T-KiriyaShowaDenshi/Kicad/kicad_arduino_LCD/部品表.xlsx

 | リファレンス | 数量 | 部品種類 | メーカー | 型式/定数 | 実装種類 | パッケージ | ピン数/部品 | 合計ピン数 | 備考
1 | C1 C2 C3 C4 | 4 | 1608積層セラミックコンデンサ0.1u |  | C0603C104Z3VACTU | SMD | 1608M | 2 | 8 |  | 合計実装数 | 34 | 合計ピン数 | 109
2 | D1 | 1 | LED Φ5 赤色 |  | HLMP-4700 | DIP |  | 2 | 2 |  | SMD部品数 | 21 | SMDピン数 | 42
3 | LCD1 | 1 | 小型LCD | Xiamen Zettler Electronics Co., Ltd. | AQM0802A-RN-GBW | DIP |  | 9 | 9 |  | DIP部品数 | 13 | DIPピン数 | 67
4 | P1 | 1 | ピンヘッダ（Power） |  | C-00167 | DIP |  | 8 | 8 | 必要ピン数を切り取って実装
5 | P2 | 1 | ピンヘッダ（Analog） |  | C-00167 | DIP |  | 6 | 6 | 必要ピン数を切り取って実装
6 | P3 | 1 | ピンヘッダ（Digital） |  | C-00167 | DIP |  | 10 | 10 | 必要ピン数を切り取って実装
7 | P4 | 1 | ピンヘッダ（Digital） |  | C-00167 | DIP |  | 6 | 6 | 必要ピン数を切り取って実装
8 | R1 R2 | 2 | 1608 一般抵抗 2kΩ |  | RC0603JR-072KL | SMD | 1608M | 2 | 4
9 | R3 R4 R5 R11 R12 R13 R14 R15 R16 R17 | 10 | 1608 一般抵抗 10kΩ |  | RC0603JR-0710KL | SMD | 1608M | 2 | 20
10 | R6 | 1 | 1608 一般抵抗 1kΩ |  | RC06003J 1K | SMD | 1608M | 2 | 2
11 | R7 R8 R9 R10 | 4 | 1608 一般抵抗 4.7kΩ |  | RC0603JR-074K7L | SMD | 1608M | 2 | 8
12 | SW1 SW2 SW3 SW4 | 4 | タクトスイッチ（赤色） |  | SKHHBY | DIP |  | 2 | 8
13 | U1 | 1 | RTCモジュール | アナログデバイセズ | DS1307+ | DIP | SOIC8 | 8 | 8 | 社内在庫なし
14 | U2 | 1 | I2Cバス用双方向電圧レベル変換モジュール | 秋月電子通商 | AE-FXMA2102 | DIP | SOIC8 | 8 | 8 | AE-PCA9306から変更、OEピンをhighにすること
15 | Y1 | 1 | 水晶発振子 |  | NC38 32.768kHz | DIP |  | 2 | 2 | VT-200-F 32.768kHzから変更、社内在庫品
