T-KiriyaShowaDenshi/Kicad/kicad_arduino_LCD/回路図.pdf

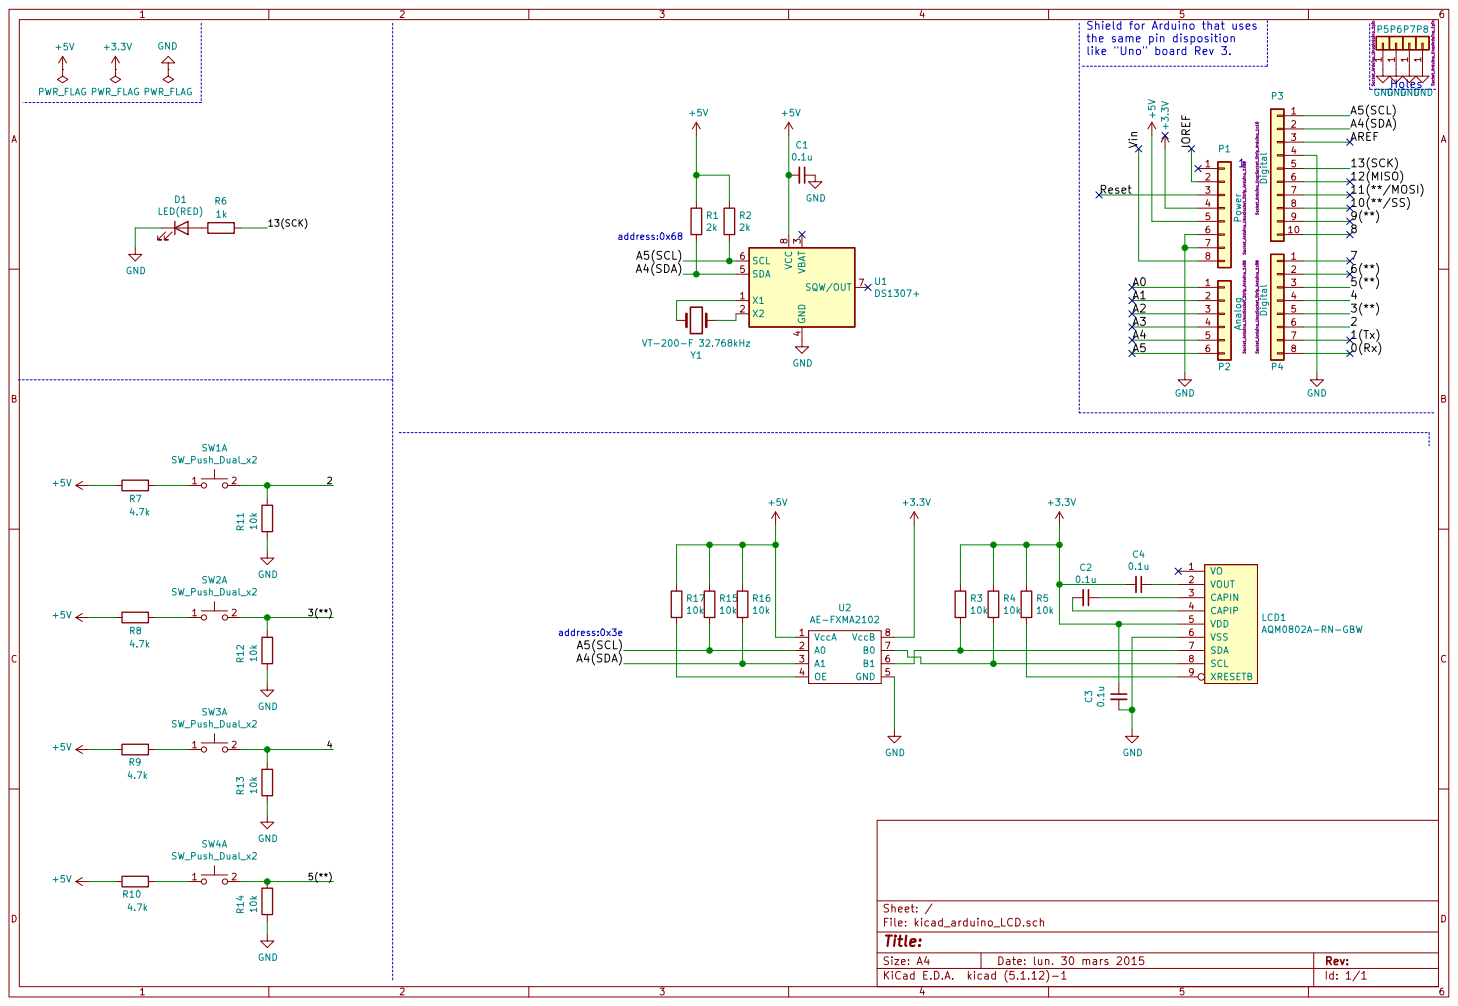
[picture p1: page 1]

the same pin disposition
like "Uno" board Rev 3.

4 SDA 5 SCL 6 SQW/OUT 7 VCC

10k GND GND GND GND R14 10k R13 10k R12 10k R11 10k R7
