T-KiriyaShowaDenshi/Kicad/(list of files, drawings)

Other design files:
kicad_arduino_LCD/kicad_arduino_LCD.dsn
