T-KiriyaShowaDenshi/Kicad/kicad_arduino_LCD/kicad_arduino_LCD.kicad_pcb

## KiCad design kicad_arduino_LCD/kicad_arduino_LCD.kicad_pcb (2021-12-10)

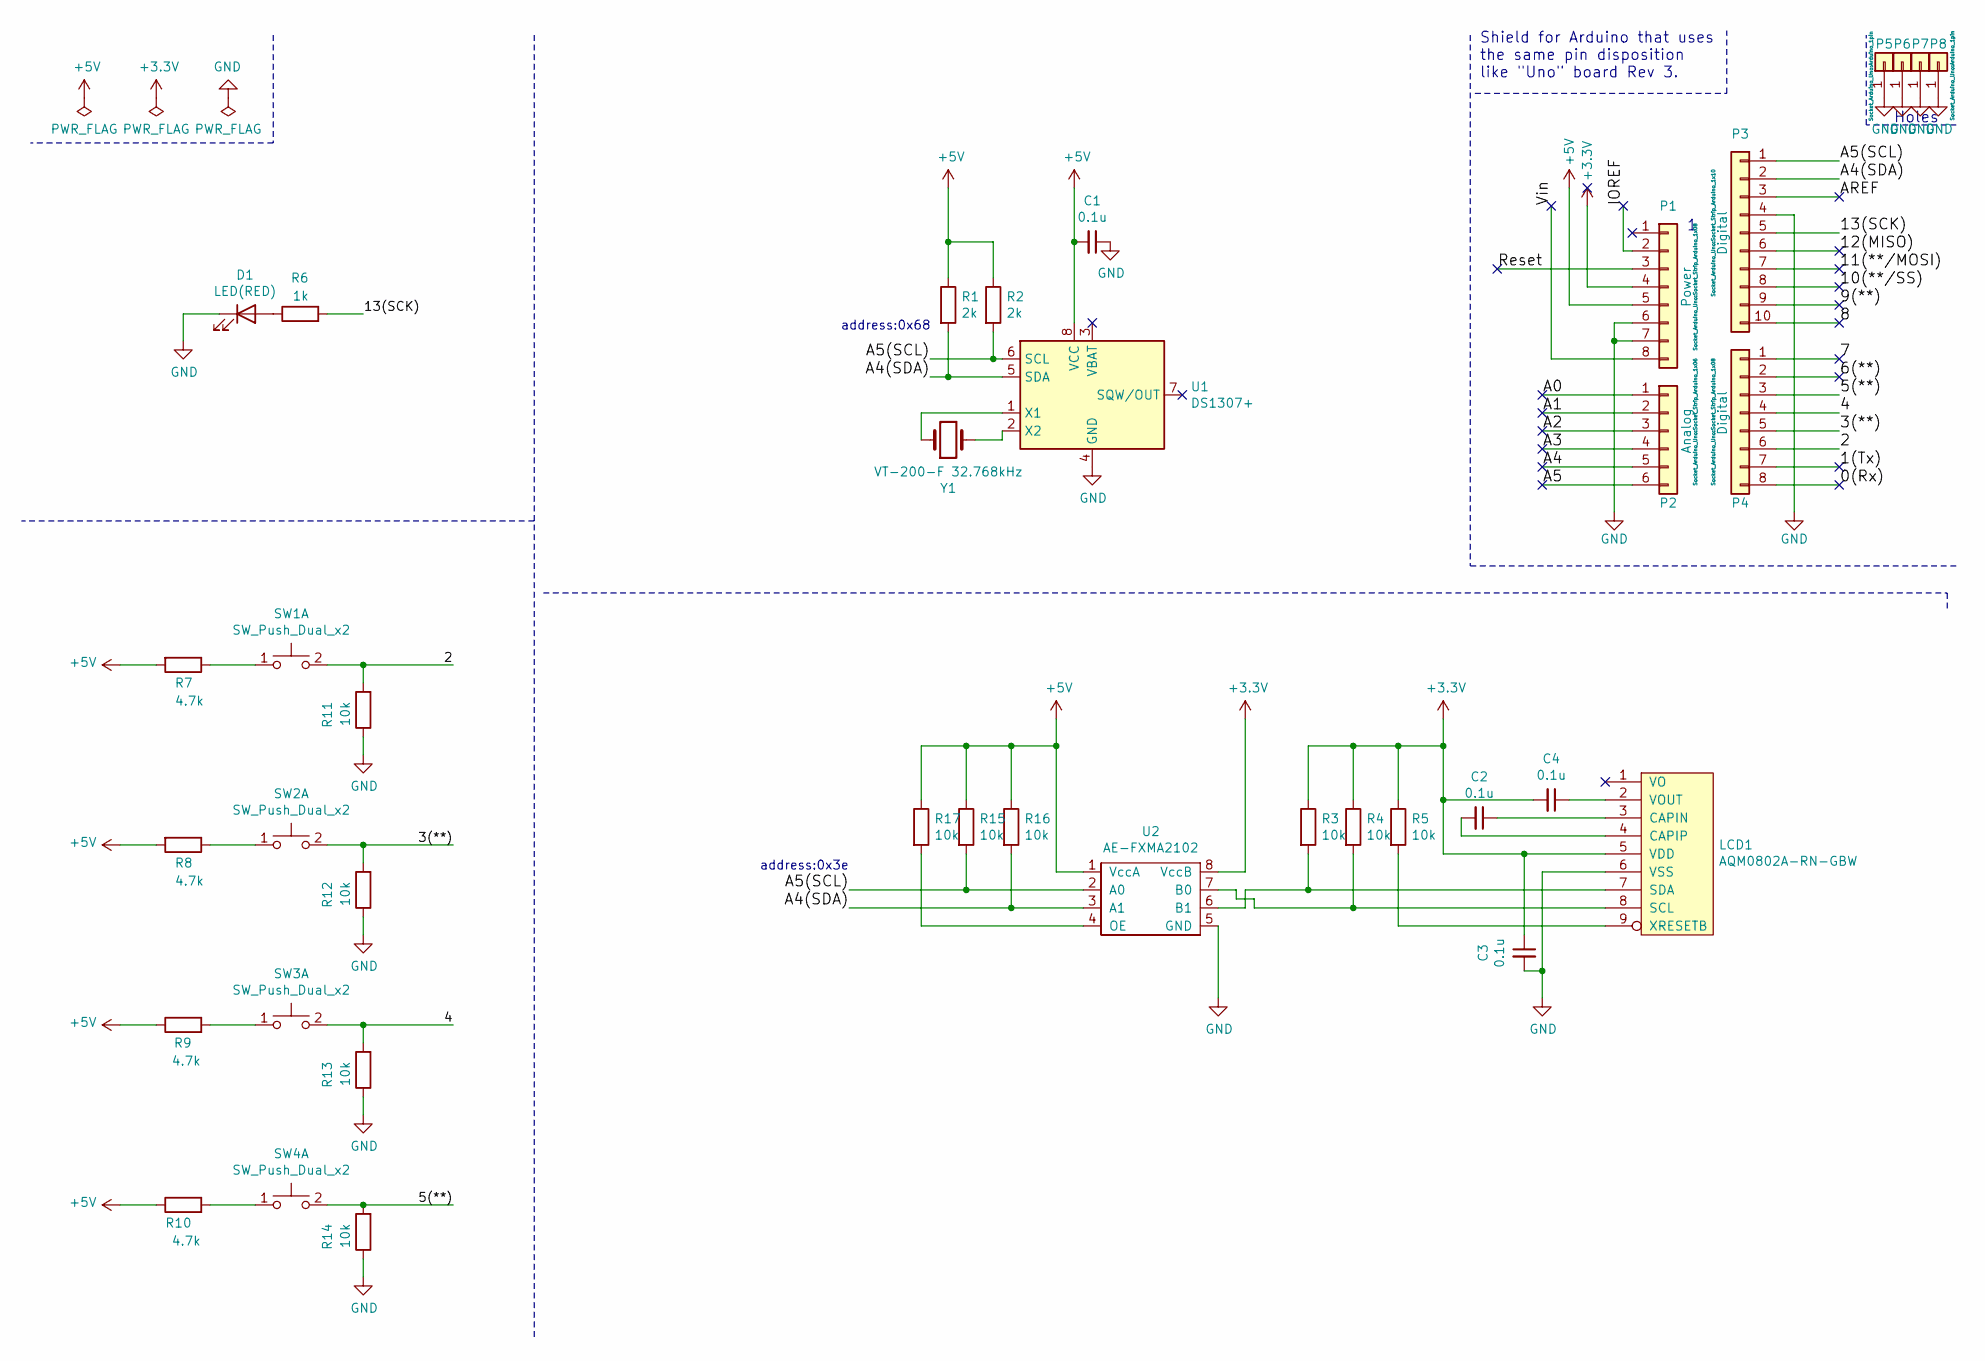
[picture p2: schematic kicad_arduino_LCD.sch]

Parts:
C1, C2, C3, C4: 0.1u; 1608
D1: LED(RED); LED_5mm
LCD1: AQM0802A-RN-GBW; lcd_AQM0802A-RN-GBW
P1: Power; Socket_Strip_Arduino_1x08
P2: Analog; Socket_Strip_Arduino_1x06
P3: Digital; Socket_Strip_Arduino_1x10
P4: Digital; Socket_Strip_Arduino_1x08
P5, P6, P7, P8: CONN_01X01; Arduino_1pin
R1, R2: 2k; 1608
R3, R4, R5, R11, R12, R13, R14, R15, R16, R17: 10k; 1608
R6: 1k; 1608
R7, R8, R9, R10: 4.7k; 1608
SW1, SW2, SW3, SW4: SW_Push_Dual_x2; TactSwitch
U1: DS1307+; ic_DIP-8_W7.62mm
U2: AE-FXMA2102; ic_DIP-8_W7.62mm
Y1: VT-200-F 32.768kHz; Crystal_DS26_D2.0mm_L6.0mm_Horizontal

Connections:
+3V3: C3.1, C4.2, LCD1.5 (VDD), P1.4, R3.1, R4.1, R5.1, U2.8 (VccB)
+5V: C1.2, P1.5, R1.1, R2.1, R7.2, R8.2, R9.1, R10.1, R15.1, R16.1, R17.1, U1.8 (VCC), U2.1 (VccA)
/0(Rx): P4.8
/1(Tx): P4.7
/2: P4.6, R11.2, SW1.2 (D)
/3(**): P4.5, R12.2, SW2.2 (D)
/4: P4.4, R13.2, SW3.2 (D)
/5(**): P4.3, R14.2, SW4.2 (D)
/6(**): P4.2
/7: P4.1
/8: P3.10
/9(**): P3.9
/10(**/SS): P3.8
/11(**/MOSI): P3.7
/12(MISO): P3.6
/13(SCK): P3.5, R6.2
/A0: P2.1
/A1: P2.2
/A2: P2.3
/A3: P2.4
/A4: P2.5
/A4(SDA): P3.2, R1.2, R16.2, U1.5 (SDA), U2.3 (A1)
/A5: P2.6
/A5(SCL): P3.1, R2.2, R15.2, U1.6 (SCL), U2.2 (A0)
/AREF: P3.3
/IOREF: P1.2
/Reset: P1.3
/Vin: P1.8
GND: C1.1, C3.2, D1.1 (K), LCD1.6 (VSS), P1.6, P1.7, P3.4, P5.1, P6.1, P7.1, P8.1, R11.1, R12.1, R13.1, R14.1, U1.4 (GND), U2.5 (GND)
unnamed: C2.1, LCD1.3 (CAPIN)
unnamed: C2.2, LCD1.4 (CAPIP)
unnamed: C4.1, LCD1.2 (VOUT)
unnamed: D1.2 (A), R6.1
unnamed: LCD1.7 (SDA), R3.2, U2.6 (B1)
unnamed: LCD1.8 (SCL), R4.2, U2.7 (B0)
unnamed: LCD1.9 (XRESETB), R5.2
unnamed: R7.1, SW1.1 (C)
unnamed: R8.1, SW2.1 (C)
unnamed: R9.2, SW3.1 (C)
unnamed: R10.2, SW4.1 (C)
unnamed: R17.2, U2.4 (OE)
unnamed: U1.1 (X1), Y1.1
unnamed: U1.2 (X2), Y1.2

Notes on the sheet:
Shield for Arduino that uses the same pin disposition like "Uno" board Rev 3.
Holes
address:0x68
address:0x3e

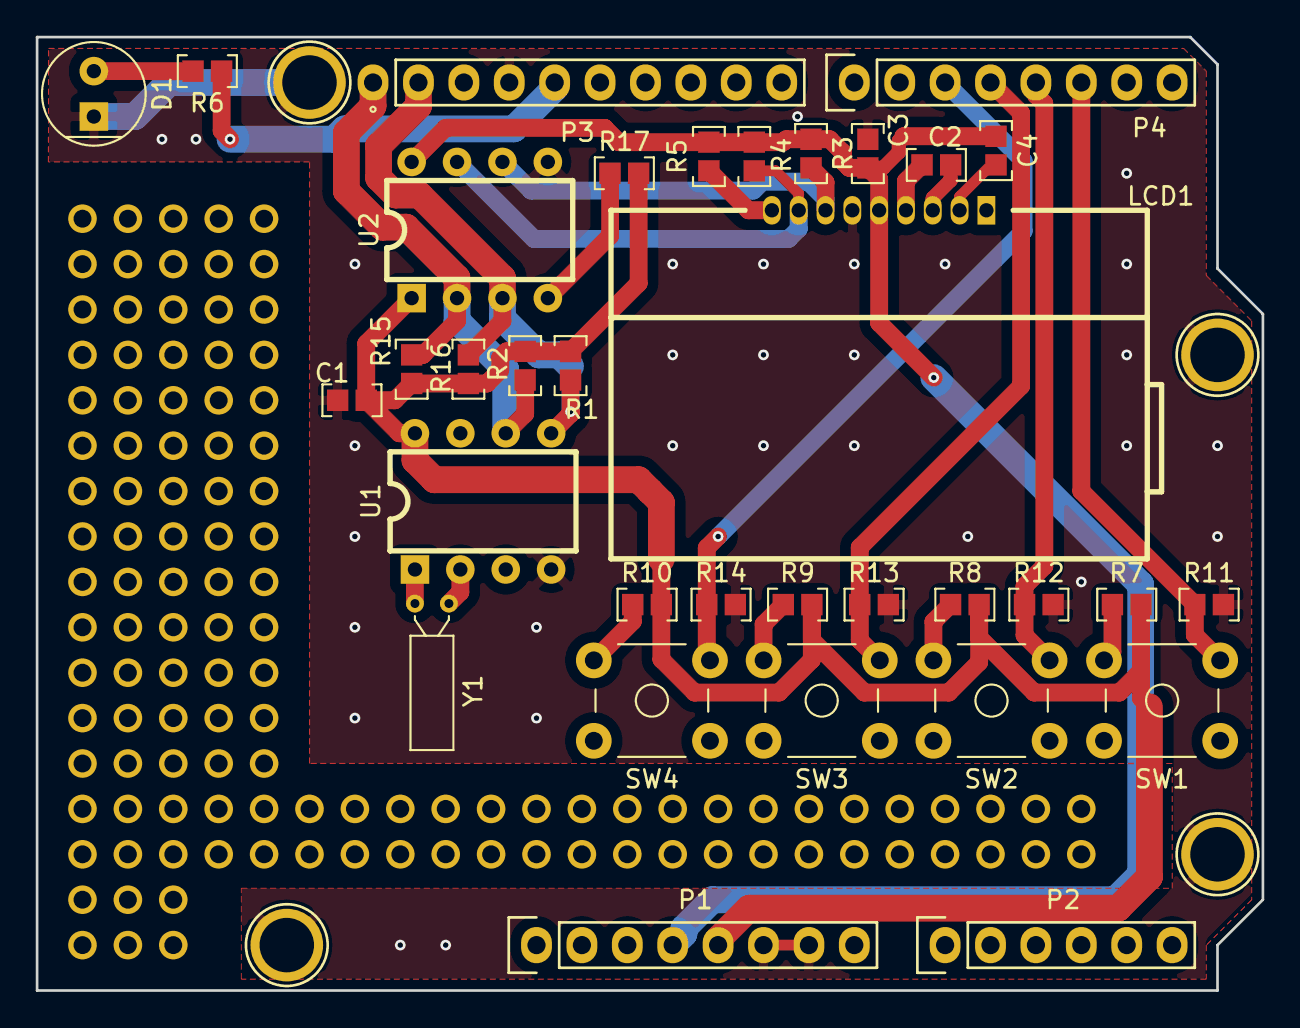
[picture p3: board kicad_arduino_LCD.kicad_pcb from above]

Board: 2 copper layers, 68.6 x 53.3 mm, 38 parts (0 on the bottom side), 24 nets.
