T-KiriyaShowaDenshi/Kicad/(commit log)

2021-12-02 Arduino用シールド基板（LCD、RTCモジュール）
    [kicad_arduino_LCD.csv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]
2021-12-02 Arduino用シールド基板（LCD&RTCモジュール）
    [部品表.csv, 部品表.xlsx]
2021-12-10 パッドと重なったシルクを削除、Designed by T.kiriya のシルクを追加
    [kicad_arduino_LCD-B_Cu.gbl, kicad_arduino_LCD-B_Mask.gbs, kicad_arduino_LCD-B_SilkS.gbo, kicad_arduino_LCD-Edge_Cuts.gm1, kicad_arduino_LCD-F_Cu.gtl, kicad_arduino_LCD-F_Mask.gts, kicad_arduino_LCD-F_SilkS.gto, kicad_arduino_LCD.drl]
2021-12-10 外形寸法の記入
    [kicad_arduino_LCD.kicad_pcb]
2021-12-13 部品表を更新（Y1：VT-200→NC38）
    [部品表.xlsx]
